DevoidAxisMods/ender5-webcam-mount/stl/ender5-webcam-mount_Tplate.stl

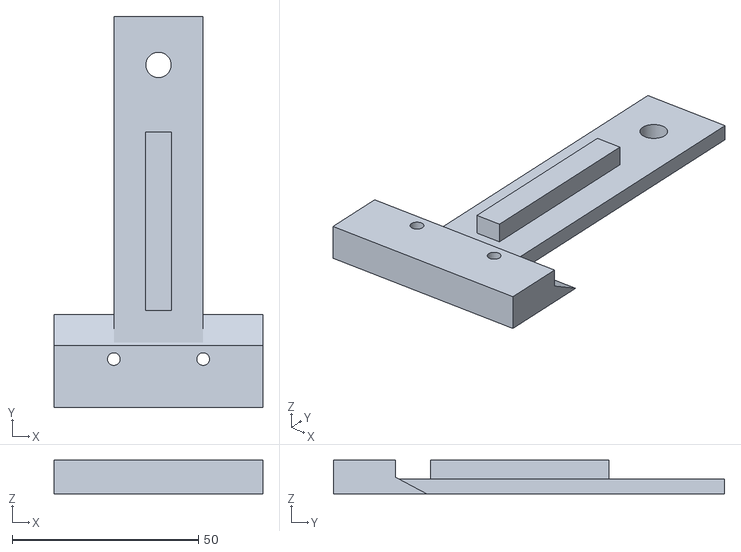
[picture p3: CAD file, 2026-08-15]
stl/ender5-webcam-mount_Tplate.stl
56.0 x 105.0 x 9.00
