DevoidAxisMods/ender5-webcam-mount/stl/thumbscrew_quarter20.stl

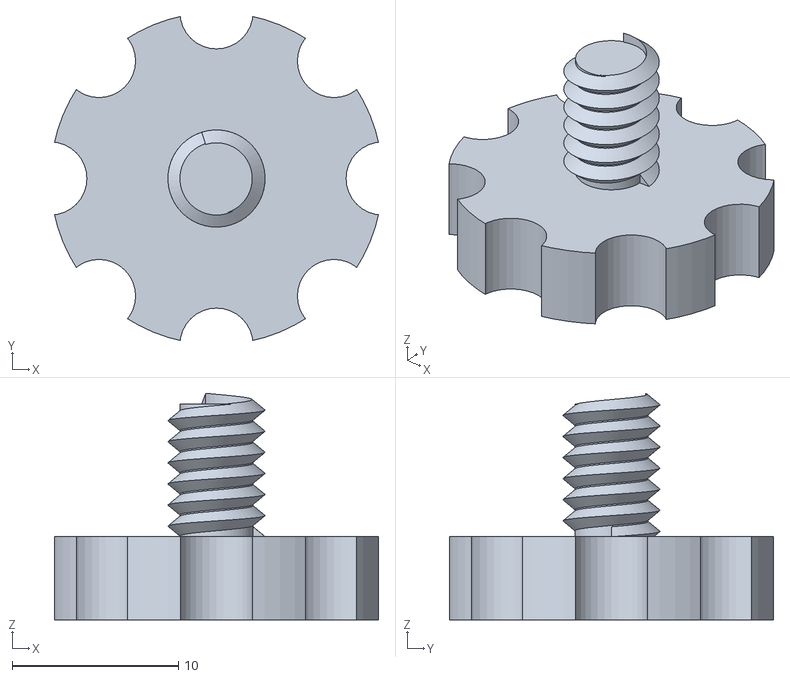
[picture p4: CAD file, 2026-08-15]
stl/thumbscrew_quarter20.stl
19.5 x 19.5 x 13.6
